carlss50/seytr-grupo-4-tocadiscos/docs/comandoGitBash.md

## Comandos GitBash
### Subir cambios a main
```bash
git pull origin main  
git add .  
git commit -m "COMENTARIO"   
git push origin main  
```

### Crear una nueva rama
```
$ git checkout -b nombre-de-la-rama  
git push origin nombre-de-la-rama   `
```
