carlss50/seytr-grupo-4-tocadiscos/images/cables-motor.jpeg

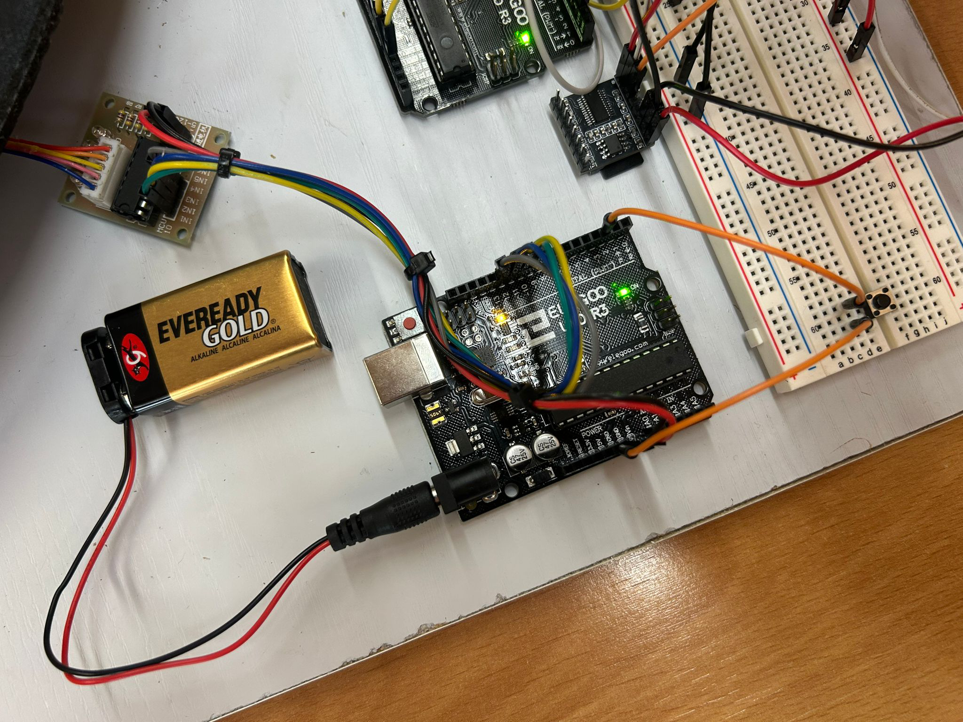
images/cables-motor.jpeg
