carlss50/seytr-grupo-4-tocadiscos/images/motor.JPG

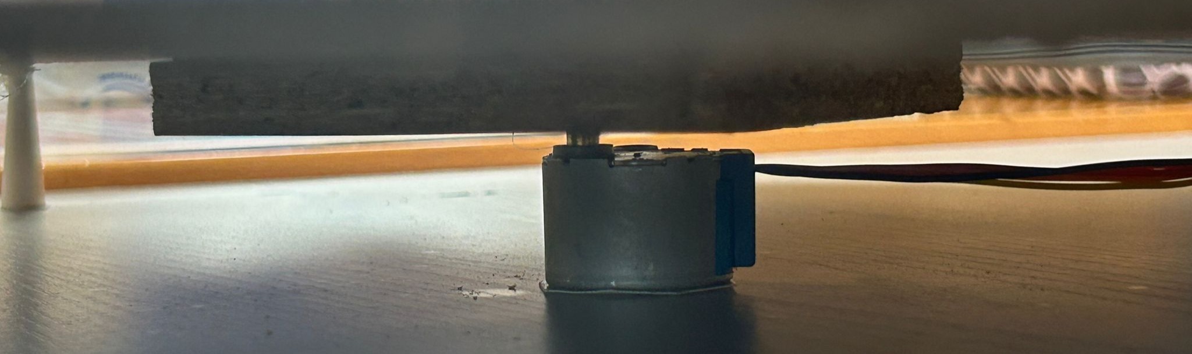
images/motor.JPG
