carlss50/seytr-grupo-4-tocadiscos/images/sensores-altavoz.JPG

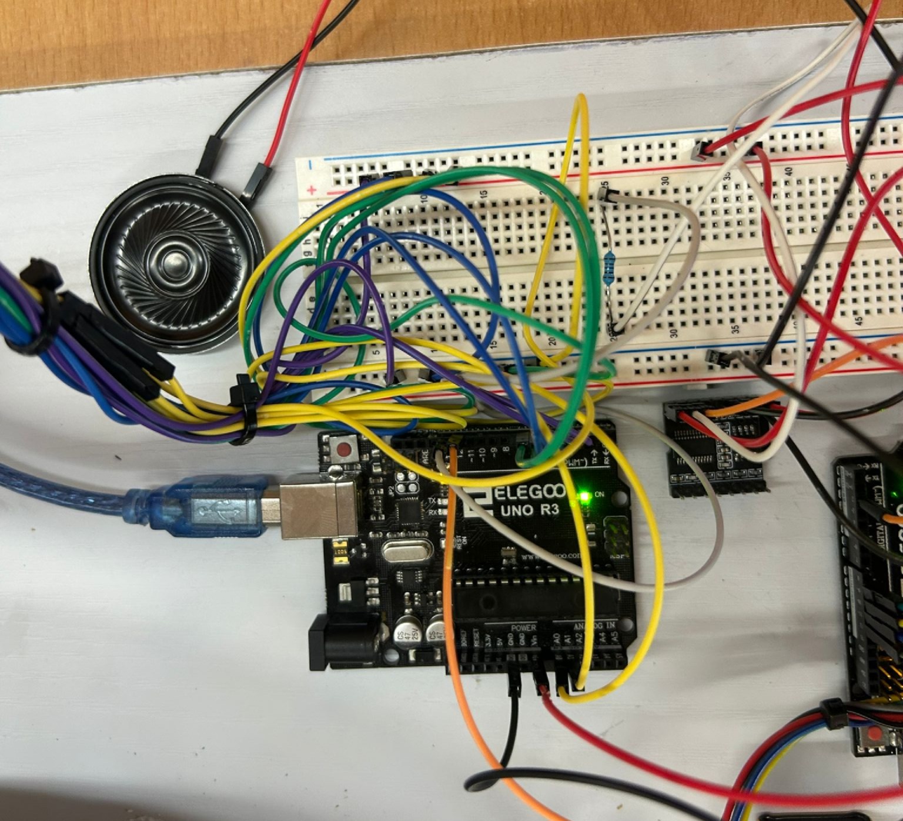
images/sensores-altavoz.JPG
