carlss50/seytr-grupo-4-tocadiscos/images/tocadiscos-perfil.jpeg

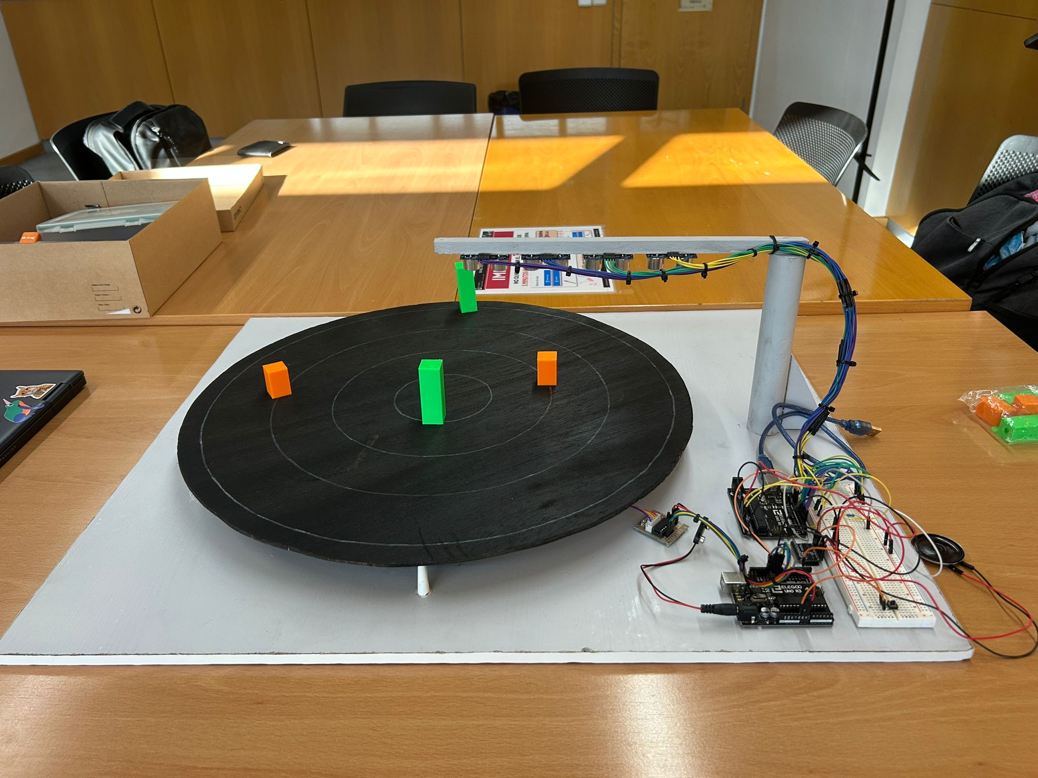
images/tocadiscos-perfil.jpeg
