carlss50/seytr-grupo-4-tocadiscos/images/tocadiscos-planta.JPG

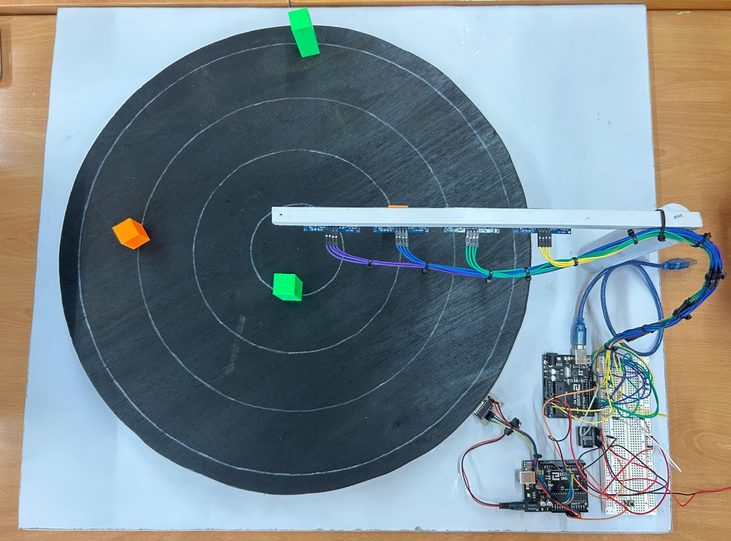
images/tocadiscos-planta.JPG
