carlss50/seytr-grupo-4-tocadiscos/(commit log)

2026-04-22 Documento txt para los comandos básicos de git bash
2026-04-22 Update README to include components information
    Added components section to README with details about the stepper motor.
2026-04-22 Código de prueba para el motor
2026-04-22 Código de prueba para los 4 sensores
2026-04-22 Add ultrasonic sensors to components list
2026-04-22 Cambio de txt a md
2026-04-23 Prueba de los altavoces
2026-04-23 Código para 4 sensores
2026-04-23 Código de sensores terminado
2026-04-23 Primer código sensores y dfplayer funciona
2026-04-23 hysteresis, evitar que una mala detección rompa el sonido
2026-04-24 Solución a la oscilanción
2026-04-25 cambio codigo de sensores
    Agregué los cambios que dije en el grupo:
    1. valida 3 veces la ficha antes de mandar la orden para sonar la nota
    2. modifique la funcion medirDistancia (cambio de tipo int -> float, no promedia todas las lecturas)
    3. hice una funcion clasificarDistancia, decide que ficha es la leida
2026-04-25 Modificado de codifo SensoresMaty
    Acortado tiempos de pausas, menos validaciones y corregido nota 0
2026-04-26 Update connection pin section in README
2026-04-26 Carpeta de imagenes.
2026-04-26 Update image link for sensor and speaker connections
2026-04-26 Update image path for sensor and speaker connection
2026-04-26 Conexiones del motor.
2026-04-26 Add motor connection pins section to README
    Added connection pins section for the motor with a diagram.
2026-04-26 Revise connection pin sections in README
    Updated headings and image captions for connection pins.
2026-04-26 Refactor sensor thresholds and improve logic
